gabeak2/STM32H743ZI_actuator_daughterboard/STM32H743ZI_actuator_daughterboard.kicad_pcb

## KiCad design STM32H743ZI_actuator_daughterboard.kicad_pcb (2026-04-05)

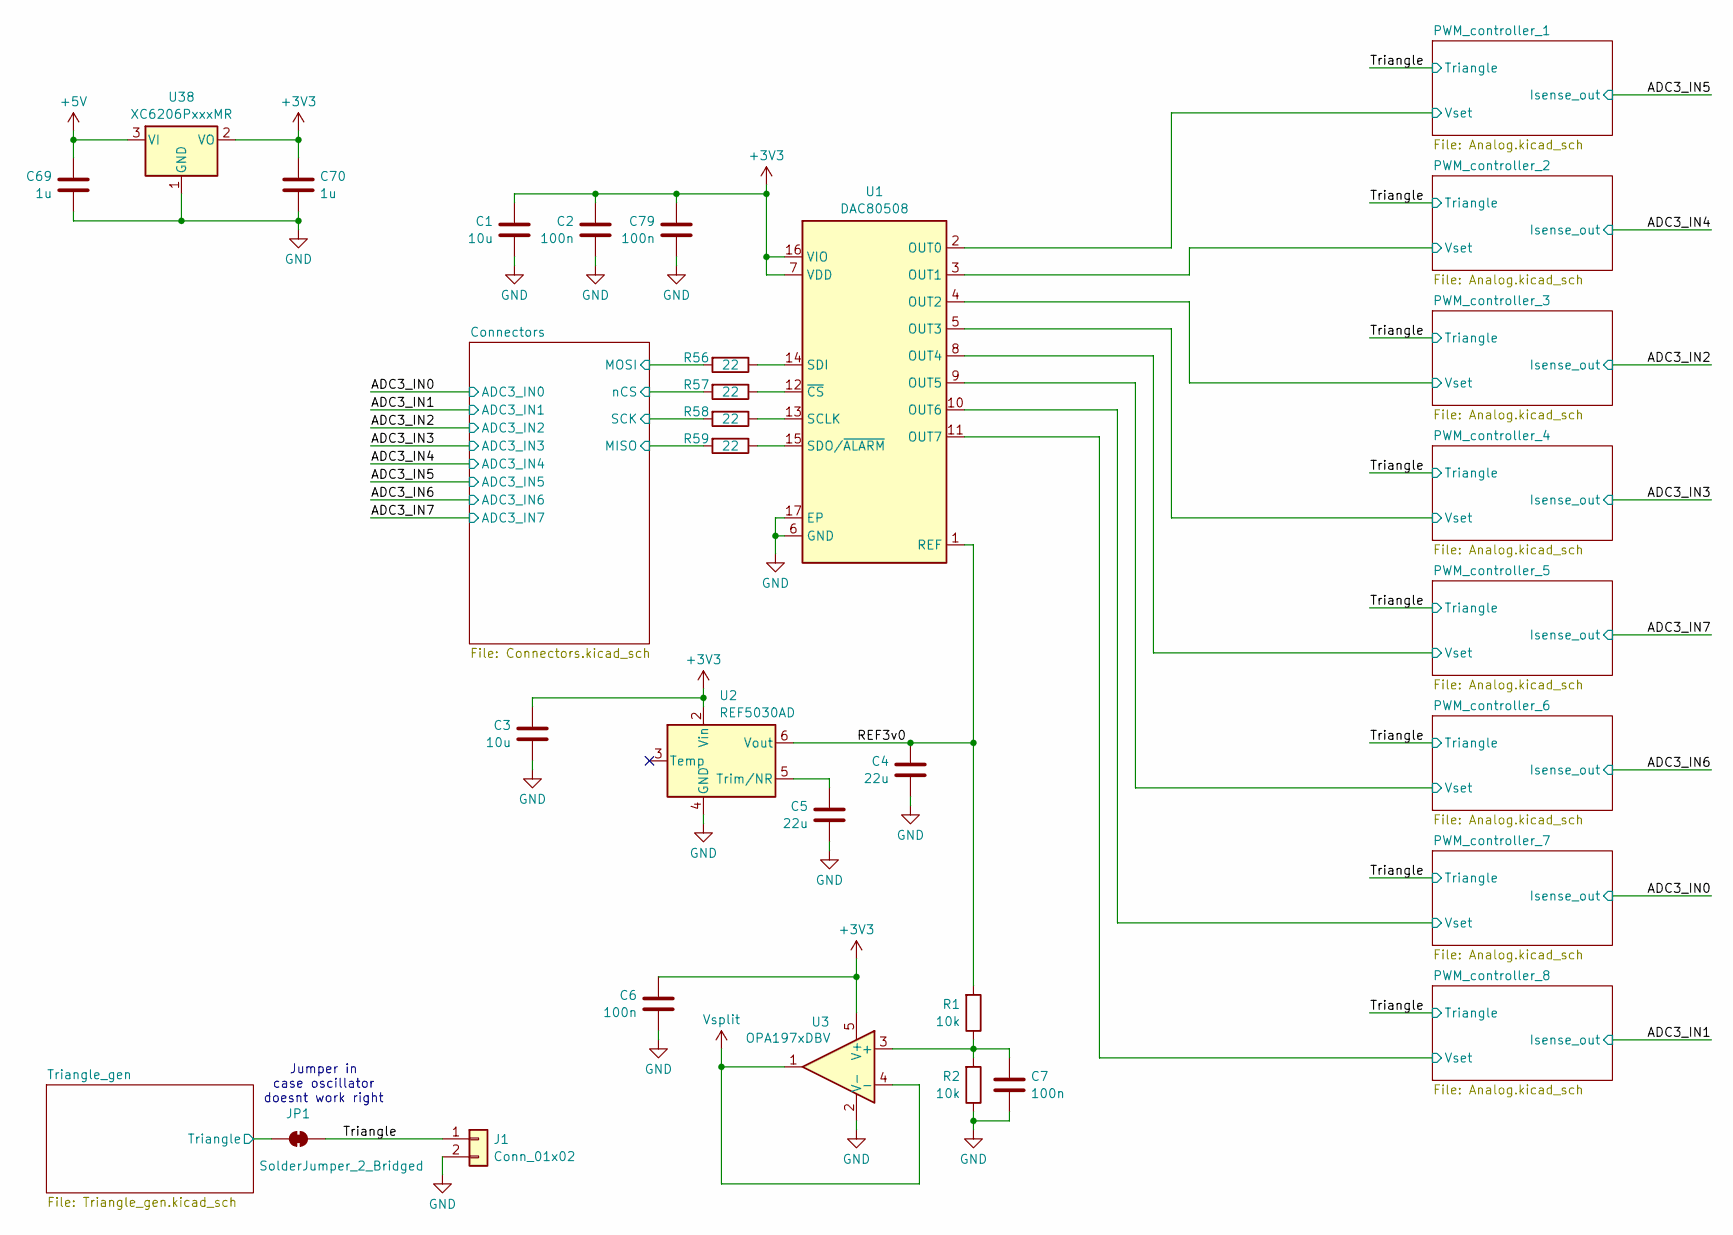
[picture p1: schematic STM32H743ZI_actuator_daughterboard.kicad_sch]

Parts:
C1, C3: 10u; C_0603_1608Metric; LCSC C19702
C2, C6, C7, C79: 100n; C_0603_1608Metric; LCSC C14663
C4, C5: 22u; C_0603_1608Metric; LCSC C59461
C69, C70: 1u; C_0603_1608Metric; LCSC C52923
J1: Conn_01x02; PinHeader_1x02_P2.54mm_Vertical
JP1: SolderJumper_2_Bridged; SolderJumper-2_P1.3mm_Bridged2Bar_Pad1.0x1.5mm
R1, R2: 10k; R_0603_1608Metric; LCSC C25804
R56, R57, R58, R59: 22; R_0603_1608Metric; LCSC C23345
U1: DAC80508; Texas_RTE0016D_WQFN-16-1EP_3x3mm_P0.5mm_EP0.8x0.8mm_Thermal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; LCSC C2679499
U2: REF5030AD; SOIC-8_3.9x4.9mm_P1.27mm; LCSC C69362
U3: OPA197xDBV; SOT-23-5; LCSC C221351
U38: XC6206PxxxMR; SOT-23-3; LCSC C5446

Connections:
+3V3: C1.1, C2.1, C3.1, C6.1, C70.1, C79.1, U1.7 (VDD), U1.16 (VIO), U2.2 (Vin), U3.5 (V+), U38.2 (VO); also elsewhere on the board
+5V: C69.1, U38.3 (VI); also elsewhere on the board
/Connectors/SPI1_MISO: R59.2; also elsewhere on the board
/Connectors/SPI1_MOSI: R56.2; also elsewhere on the board
/Connectors/SPI1_SCK: R58.2; also elsewhere on the board
/Connectors/SPI1_nCS: R57.2; also elsewhere on the board
/PWM_controller_1/Vset: U1.2 (OUT0); also elsewhere on the board
/PWM_controller_2/Vset: U1.3 (OUT1); also elsewhere on the board
/PWM_controller_3/Vset: U1.4 (OUT2); also elsewhere on the board
/PWM_controller_4/Vset: U1.5 (OUT3); also elsewhere on the board
/PWM_controller_5/Vset: U1.8 (OUT4); also elsewhere on the board
/PWM_controller_6/Vset: U1.9 (OUT5); also elsewhere on the board
/PWM_controller_7/Vset: U1.10 (OUT6); also elsewhere on the board
/PWM_controller_8/Vset: U1.11 (OUT7); also elsewhere on the board
/REF3v0: C4.1, R1.2, U1.1 (REF), U2.6 (Vout)
/Triangle: J1.1, JP1.1 (A); also elsewhere on the board
/Triangle_gen/Triangle: JP1.2 (B); also elsewhere on the board
GND: C1.2, C2.2, C3.2, C4.2, C5.2, C6.2, C7.2, C69.2, C70.2, C79.2, J1.2, R2.1, U1.6 (GND), U1.17 (EP), U2.4 (GND), U3.2 (V-), U38.1 (GND); also elsewhere on the board
unnamed: R58.1, U1.13 (SCLK)
unnamed: R56.1, U1.14 (SDI)
unnamed: R59.1, U1.15 (SDO/~ALARM)
unnamed: R57.1, U1.12 (~CS)
unnamed: C5.1, U2.5 (Trim/NR)
unnamed: C7.1, R1.1, R2.2, U3.3 (+)
Vsplit: U3.1, U3.4 (-); also elsewhere on the board

Notes on the sheet:
Jumper in case oscillator doesnt work right

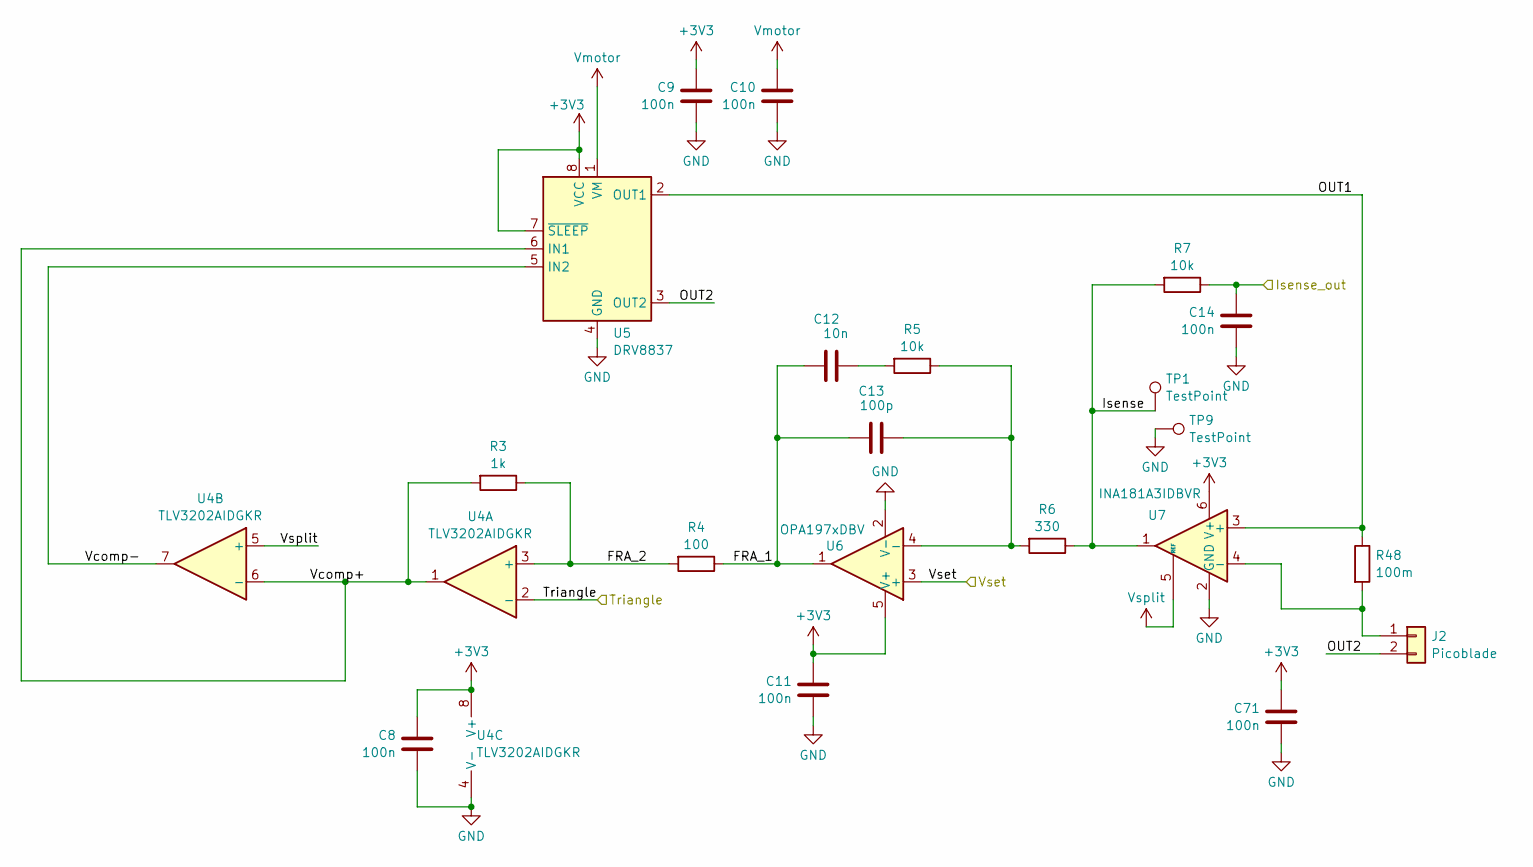
[picture p2: schematic Analog.kicad_sch]

Parts:
C8, C9, C10, C11, C14, C71: 100n; C_0603_1608Metric; LCSC C14663
C12: 10n; C_0603_1608Metric; LCSC C57112
C13: 100p; C_0603_1608Metric; LCSC C14858
J2: Picoblade; Molex_PicoBlade_53047-0210_1x02_P1.25mm_Vertical
R3: 1k; R_0603_1608Metric; LCSC C21190
R4: 100; R_0603_1608Metric; LCSC C22775
R5, R7: 10k; R_0603_1608Metric; LCSC C25804
R6: 330; R_0603_1608Metric; LCSC C23138
R48: 100m; R_1206_3216Metric; LCSC C25334
TP1, TP9: TestPoint; scope_tp
U4: TLV3202AIDGKR; VSSOP-8_3x3mm_P0.65mm; LCSC C478075
U5: DRV8837; WSON-8-1EP_2x2mm_P0.5mm_EP0.9x1.6mm; LCSC C39159
U6: OPA197xDBV; SOT-23-5; LCSC C221351
U7: INA181A3IDBVR; SOT-23-6; LCSC C2652255

Connections:
+3V3: C8.1, C9.1, C11.1, C71.1, U4.8 (V+), U5.7 (~SLEEP), U5.8 (VCC), U6.5 (V+), U7.6 (V+); also elsewhere on the board
/ADC3_IN5: C14.1, R7.1; also elsewhere on the board
/PWM_controller_1/FRA_1: C12.1, C13.1, R4.1, U6.1
/PWM_controller_1/FRA_2: R3.1, R4.2, U4.3 (+)
/PWM_controller_1/Isense: R6.1, R7.2, TP1.1 (1_1), U7.1
/PWM_controller_1/OUT1: R48.1, U5.2 (OUT1), U7.3 (+)
/PWM_controller_1/OUT2: J2.2, U5.3 (OUT2)
/PWM_controller_1/Vcomp+: R3.2, U4.1, U4.6 (-), U5.6 (IN1)
/PWM_controller_1/Vcomp-: U4.7, U5.5 (IN2)
/PWM_controller_1/Vset: U6.3 (+); also elsewhere on the board
/Triangle: U4.2 (-); also elsewhere on the board
GND: C8.2, C9.2, C10.2, C11.2, C14.2, C71.2, TP9.1 (1_1), U4.4 (V-), U5.4 (GND), U5.9 (GND), U6.2 (V-), U7.2 (GND); also elsewhere on the board
unnamed: C12.2, R5.2
unnamed: J2.1, R48.2, U7.4 (-)
unnamed: C13.2, R5.1, R6.2, U6.4 (-)
Vmotor: C10.1, U5.1 (VM); also elsewhere on the board
Vsplit: U4.5 (+), U7.5 (REF); also elsewhere on the board

Parts of its further copies:
C15, C16, C19, C20, C21, C22, C23, C26, C27, C28, C29, C30, C33, C34, C35, C36, C37, C40, C41, C42, C43, C44, C47, C48, C49, C50, C51, C54, C55, C56, C57, C58, C61, C62, C63, C72, C73, C74, C75, C76, C77, C78: 100n; C_0603_1608Metric; LCSC C14663
C17, C24, C31, C38, C45, C52, C59: 10n; C_0603_1608Metric; LCSC C57112
C18, C25, C32, C39, C46, C53, C60: 100p; C_0603_1608Metric; LCSC C14858
J5, J7, J9, J11, J13, J15, J17: Picoblade; Molex_PicoBlade_53047-0210_1x02_P1.25mm_Vertical
R8, R13, R18, R23, R28, R33, R38, R49, R50, R51, R52, R53, R54, R55: 10k; R_0603_1608Metric; LCSC C25804
R9, R14, R19, R24, R29, R34, R39: 1k; R_0603_1608Metric; LCSC C21190
R10, R15, R20, R25, R30, R35, R40: 330; R_0603_1608Metric; LCSC C23138
R11, R16, R21, R26, R31, R36, R41: 100; R_0603_1608Metric; LCSC C22775
R12, R17, R22, R27, R32, R37, R42: 100m; R_1206_3216Metric; LCSC C25334
TP2, TP3, TP4, TP5, TP6, TP7, TP8, TP10, TP11, TP12, TP13, TP14, TP15, TP16: TestPoint; scope_tp
U8, U12, U16, U20, U24, U28, U32: DRV8837; WSON-8-1EP_2x2mm_P0.5mm_EP0.9x1.6mm; LCSC C39159
U9, U13, U17, U21, U25, U29, U33: INA181A3IDBVR; SOT-23-6; LCSC C2652255
U10, U14, U18, U22, U26, U30, U34: TLV3202AIDGKR; VSSOP-8_3x3mm_P0.65mm; LCSC C478075
U11, U15, U19, U23, U27, U31, U35: OPA197xDBV; SOT-23-5; LCSC C221351

Connections of its further copies:
+3V3: C15.1, C19.1, C20.1, C21.1, C22.1, C26.1, C27.1, C28.1, C29.1, C33.1, C34.1, C35.1, C36.1, C40.1, C41.1, C42.1, C43.1, C47.1, C48.1, C49.1, C50.1, C54.1, C55.1, C56.1, C57.1, C61.1, C62.1, C63.1, U8.7 (~SLEEP), U8.8 (VCC), U9.6 (V+), U10.8 (V+), U11.5 (V+), U12.7 (~SLEEP), U12.8 (VCC), U13.6 (V+), U14.8 (V+), U15.5 (V+), U16.7 (~SLEEP), U16.8 (VCC), U17.6 (V+), U18.8 (V+), U19.5 (V+), U20.7 (~SLEEP), U20.8 (VCC), U21.6 (V+), U22.8 (V+), U23.5 (V+), U24.7 (~SLEEP), U24.8 (VCC), U25.6 (V+), U26.8 (V+), U27.5 (V+), U28.7 (~SLEEP), U28.8 (VCC), U29.6 (V+), U30.8 (V+), U31.5 (V+), U32.7 (~SLEEP), U32.8 (VCC), U33.6 (V+), U34.8 (V+), U35.5 (V+); also elsewhere on the board
/ADC3_IN0: C77.1, R54.1; also elsewhere on the board
/ADC3_IN1: C78.1, R55.1; also elsewhere on the board
/ADC3_IN2: C73.1, R50.1; also elsewhere on the board
/ADC3_IN3: C74.1, R51.1; also elsewhere on the board
/ADC3_IN4: C72.1, R49.1; also elsewhere on the board
/ADC3_IN6: C76.1, R53.1; also elsewhere on the board
/ADC3_IN7: C75.1, R52.1; also elsewhere on the board
/PWM_controller_2/FRA_1: C17.1, C18.1, R11.1, U11.1
/PWM_controller_2/FRA_2: R9.1, R11.2, U10.3 (+)
/PWM_controller_2/Isense: R10.1, R49.2, TP2.1 (1_1), U9.1
/PWM_controller_2/OUT1: R12.1, U8.2 (OUT1), U9.3 (+)
/PWM_controller_2/OUT2: J5.2, U8.3 (OUT2)
/PWM_controller_2/Vcomp+: R9.2, U8.6 (IN1), U10.1, U10.6 (-)
/PWM_controller_2/Vcomp-: U8.5 (IN2), U10.7
/PWM_controller_2/Vset: U11.3 (+); also elsewhere on the board
/PWM_controller_3/FRA_1: C24.1, C25.1, R16.1, U15.1
/PWM_controller_3/FRA_2: R14.1, R16.2, U14.3 (+)
/PWM_controller_3/Isense: R15.1, R50.2, TP3.1 (1_1), U13.1
/PWM_controller_3/OUT1: R17.1, U12.2 (OUT1), U13.3 (+)
/PWM_controller_3/OUT2: J7.2, U12.3 (OUT2)
/PWM_controller_3/Vcomp+: R14.2, U12.6 (IN1), U14.1, U14.6 (-)
/PWM_controller_3/Vcomp-: U12.5 (IN2), U14.7
/PWM_controller_3/Vset: U15.3 (+); also elsewhere on the board
/PWM_controller_4/FRA_1: C31.1, C32.1, R21.1, U19.1
/PWM_controller_4/FRA_2: R19.1, R21.2, U18.3 (+)
/PWM_controller_4/Isense: R20.1, R51.2, TP4.1 (1_1), U17.1
/PWM_controller_4/OUT1: R22.1, U16.2 (OUT1), U17.3 (+)
/PWM_controller_4/OUT2: J9.2, U16.3 (OUT2)
/PWM_controller_4/Vcomp+: R19.2, U16.6 (IN1), U18.1, U18.6 (-)
/PWM_controller_4/Vcomp-: U16.5 (IN2), U18.7
/PWM_controller_4/Vset: U19.3 (+); also elsewhere on the board
/PWM_controller_5/FRA_1: C38.1, C39.1, R26.1, U23.1
/PWM_controller_5/FRA_2: R24.1, R26.2, U22.3 (+)
/PWM_controller_5/Isense: R25.1, R52.2, TP5.1 (1_1), U21.1
/PWM_controller_5/OUT1: R27.1, U20.2 (OUT1), U21.3 (+)
/PWM_controller_5/OUT2: J11.2, U20.3 (OUT2)
/PWM_controller_5/Vcomp+: R24.2, U20.6 (IN1), U22.1, U22.6 (-)
/PWM_controller_5/Vcomp-: U20.5 (IN2), U22.7
/PWM_controller_5/Vset: U23.3 (+); also elsewhere on the board
/PWM_controller_6/FRA_1: C45.1, C46.1, R31.1, U27.1
/PWM_controller_6/FRA_2: R29.1, R31.2, U26.3 (+)
/PWM_controller_6/Isense: R30.1, R53.2, TP6.1 (1_1), U25.1
/PWM_controller_6/OUT1: R32.1, U24.2 (OUT1), U25.3 (+)
/PWM_controller_6/OUT2: J13.2, U24.3 (OUT2)
/PWM_controller_6/Vcomp+: R29.2, U24.6 (IN1), U26.1, U26.6 (-)
/PWM_controller_6/Vcomp-: U24.5 (IN2), U26.7
/PWM_controller_6/Vset: U27.3 (+); also elsewhere on the board
/PWM_controller_7/FRA_1: C52.1, C53.1, R36.1, U31.1
/PWM_controller_7/FRA_2: R34.1, R36.2, U30.3 (+)
/PWM_controller_7/Isense: R35.1, R54.2, TP7.1 (1_1), U29.1
/PWM_controller_7/OUT1: R37.1, U28.2 (OUT1), U29.3 (+)
/PWM_controller_7/OUT2: J15.2, U28.3 (OUT2)
/PWM_controller_7/Vcomp+: R34.2, U28.6 (IN1), U30.1, U30.6 (-)
/PWM_controller_7/Vcomp-: U28.5 (IN2), U30.7
/PWM_controller_7/Vset: U31.3 (+); also elsewhere on the board
/PWM_controller_8/FRA_1: C59.1, C60.1, R41.1, U35.1
/PWM_controller_8/FRA_2: R39.1, R41.2, U34.3 (+)
/PWM_controller_8/Isense: R40.1, R55.2, TP8.1 (1_1), U33.1
/PWM_controller_8/OUT1: R42.1, U32.2 (OUT1), U33.3 (+)
/PWM_controller_8/OUT2: J17.2, U32.3 (OUT2)
/PWM_controller_8/Vcomp+: R39.2, U32.6 (IN1), U34.1, U34.6 (-)
/PWM_controller_8/Vcomp-: U32.5 (IN2), U34.7
/PWM_controller_8/Vset: U35.3 (+); also elsewhere on the board
/Triangle: U10.2 (-), U14.2 (-), U18.2 (-), U22.2 (-), U26.2 (-), U30.2 (-), U34.2 (-); also elsewhere on the board
GND: C15.2, C16.2, C19.2, C20.2, C21.2, C22.2, C23.2, C26.2, C27.2, C28.2, C29.2, C30.2, C33.2, C34.2, C35.2, C36.2, C37.2, C40.2, C41.2, C42.2, C43.2, C44.2, C47.2, C48.2, C49.2, C50.2, C51.2, C54.2, C55.2, C56.2, C57.2, C58.2, C61.2, C62.2, C63.2, C72.2, C73.2, C74.2, C75.2, C76.2, C77.2, C78.2, TP10.1 (1_1), TP11.1 (1_1), TP12.1 (1_1), TP13.1 (1_1), TP14.1 (1_1), TP15.1 (1_1), TP16.1 (1_1), U8.4 (GND), U8.9 (GND), U9.2 (GND), U10.4 (V-), U11.2 (V-), U12.4 (GND), U12.9 (GND), U13.2 (GND), U14.4 (V-), U15.2 (V-), U16.4 (GND), U16.9 (GND), U17.2 (GND), U18.4 (V-), U19.2 (V-), U20.4 (GND), U20.9 (GND), U21.2 (GND), U22.4 (V-), U23.2 (V-), U24.4 (GND), U24.9 (GND), U25.2 (GND), U26.4 (V-), U27.2 (V-), U28.4 (GND), U28.9 (GND), U29.2 (GND), U30.4 (V-), U31.2 (V-), U32.4 (GND), U32.9 (GND), U33.2 (GND), U34.4 (V-), U35.2 (V-); also elsewhere on the board
unnamed: C17.2, R8.2
unnamed: C24.2, R13.2
unnamed: C31.2, R18.2
unnamed: C38.2, R23.2
unnamed: C45.2, R28.2
unnamed: C52.2, R33.2
unnamed: C59.2, R38.2
unnamed: J5.1, R12.2, U9.4 (-)
unnamed: J7.1, R17.2, U13.4 (-)
unnamed: J9.1, R22.2, U17.4 (-)
unnamed: J11.1, R27.2, U21.4 (-)
unnamed: J13.1, R32.2, U25.4 (-)
unnamed: J15.1, R37.2, U29.4 (-)
unnamed: J17.1, R42.2, U33.4 (-)
unnamed: C18.2, R8.1, R10.2, U11.4 (-)
unnamed: C25.2, R13.1, R15.2, U15.4 (-)
unnamed: C32.2, R18.1, R20.2, U19.4 (-)
unnamed: C39.2, R23.1, R25.2, U23.4 (-)
unnamed: C46.2, R28.1, R30.2, U27.4 (-)
unnamed: C53.2, R33.1, R35.2, U31.4 (-)
unnamed: C60.2, R38.1, R40.2, U35.4 (-)
Vmotor: C16.1, C23.1, C30.1, C37.1, C44.1, C51.1, C58.1, U8.1 (VM), U12.1 (VM), U16.1 (VM), U20.1 (VM), U24.1 (VM), U28.1 (VM), U32.1 (VM); also elsewhere on the board
Vsplit: U9.5 (REF), U10.5 (+), U13.5 (REF), U14.5 (+), U17.5 (REF), U18.5 (+), U21.5 (REF), U22.5 (+), U25.5 (REF), U26.5 (+), U29.5 (REF), U30.5 (+), U33.5 (REF), U34.5 (+); also elsewhere on the board

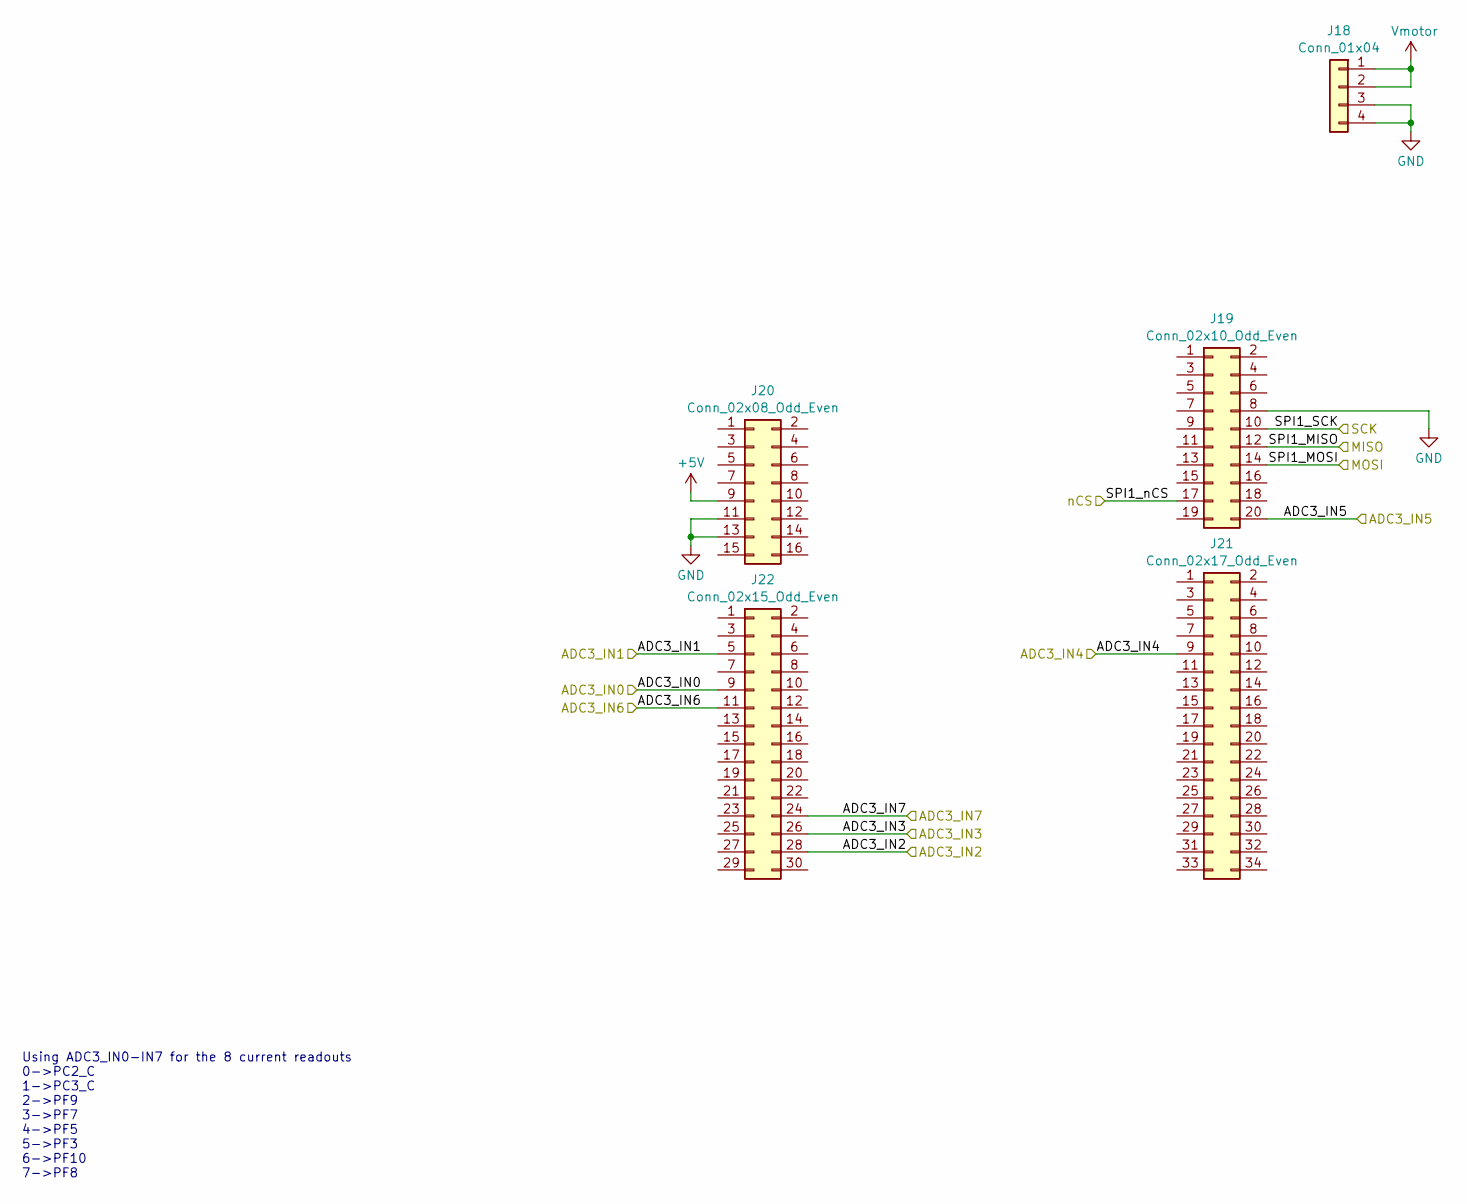
[picture p3: schematic Connectors.kicad_sch]

Parts:
J18: Conn_01x04; PinHeader_1x04_P2.54mm_Vertical
J19: Conn_02x10_Odd_Even; PinHeader_2x10_P2.54mm_Vertical
J20: Conn_02x08_Odd_Even; PinHeader_2x08_P2.54mm_Vertical
J21: Conn_02x17_Odd_Even; PinHeader_2x17_P2.54mm_Vertical
J22: Conn_02x15_Odd_Even; PinHeader_2x15_P2.54mm_Vertical

Connections:
+5V: J20.9; also elsewhere on the board
/ADC3_IN0: J22.9; also elsewhere on the board
/ADC3_IN1: J22.5; also elsewhere on the board
/ADC3_IN2: J22.28; also elsewhere on the board
/ADC3_IN3: J22.26; also elsewhere on the board
/ADC3_IN4: J21.9 (Pin_9_9); also elsewhere on the board
/ADC3_IN5: J19.20; also elsewhere on the board
/ADC3_IN6: J22.11; also elsewhere on the board
/ADC3_IN7: J22.24; also elsewhere on the board
/Connectors/SPI1_MISO: J19.12; also elsewhere on the board
/Connectors/SPI1_MOSI: J19.14; also elsewhere on the board
/Connectors/SPI1_SCK: J19.10; also elsewhere on the board
/Connectors/SPI1_nCS: J19.17; also elsewhere on the board
GND: J18.3, J18.4, J19.8, J20.11, J20.13; also elsewhere on the board
Vmotor: J18.1, J18.2; also elsewhere on the board

Notes on the sheet:
Using ADC3_IN0-IN7 for the 8 current readouts 0->PC2_C 1->PC3_C 2->PF9 3->PF7 4->PF5 5->PF3 6->PF10 7->PF8

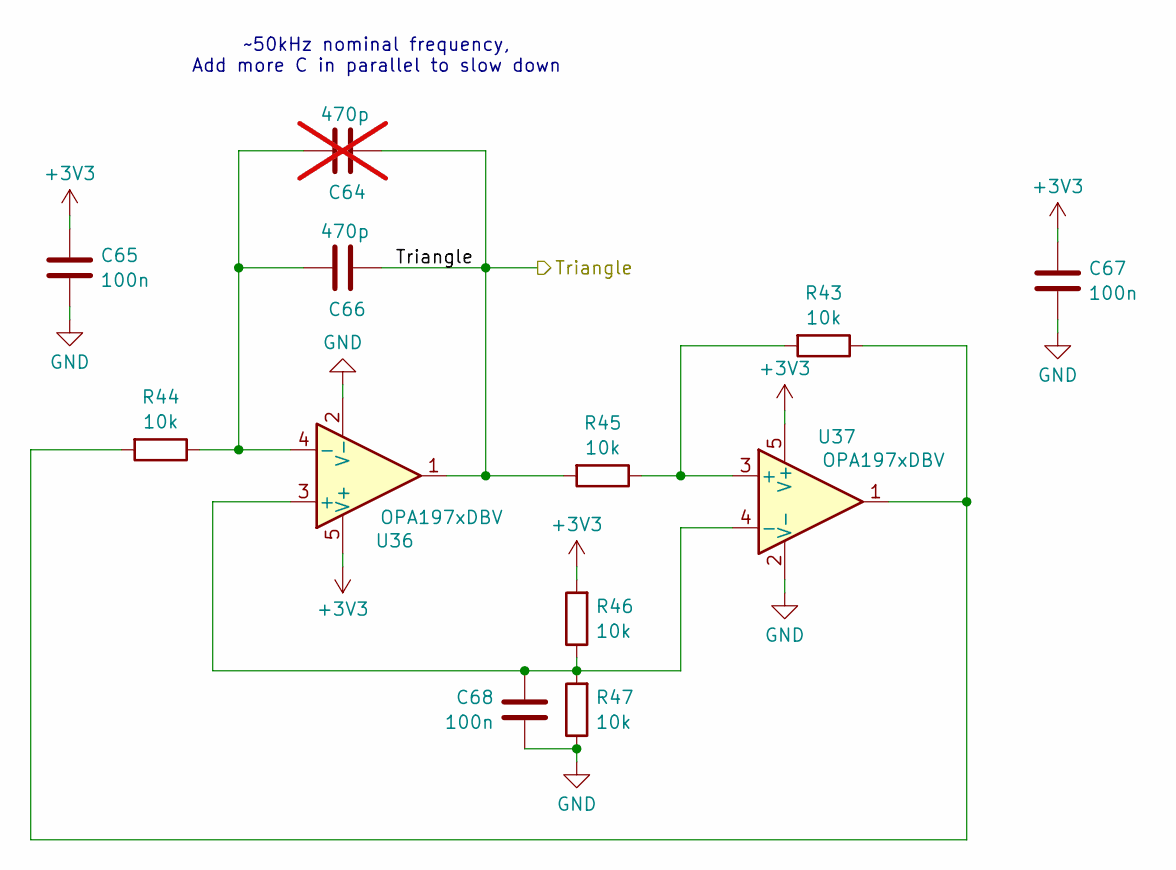
[picture p4: schematic Triangle_gen.kicad_sch]

Parts:
C64: 470p; C_0603_1608Metric; LCSC C1620; not fitted
C65, C67, C68: 100n; C_0603_1608Metric; LCSC C14663
C66: 470p; C_0603_1608Metric; LCSC C1620
R43, R44, R45, R46, R47: 10k; R_0603_1608Metric; LCSC C25804
U36, U37: OPA197xDBV; SOT-23-5; LCSC C221351

Connections:
+3V3: C65.1, C67.1, R46.2, U36.5 (V+), U37.5 (V+); also elsewhere on the board
/Triangle_gen/Triangle: C64.1, C66.1, R45.2, U36.1; also elsewhere on the board
GND: C65.2, C67.2, C68.2, R47.1, U36.2 (V-), U37.2 (V-); also elsewhere on the board
unnamed: R43.1, R44.2, U37.1
unnamed: C68.1, R46.1, R47.2, U36.3 (+), U37.4 (-)
unnamed: C64.2, C66.2, R44.1, U36.4 (-)
unnamed: R43.2, R45.1, U37.3 (+)

Notes on the sheet:
~50kHz nominal frequency, Add more C in parallel to slow down

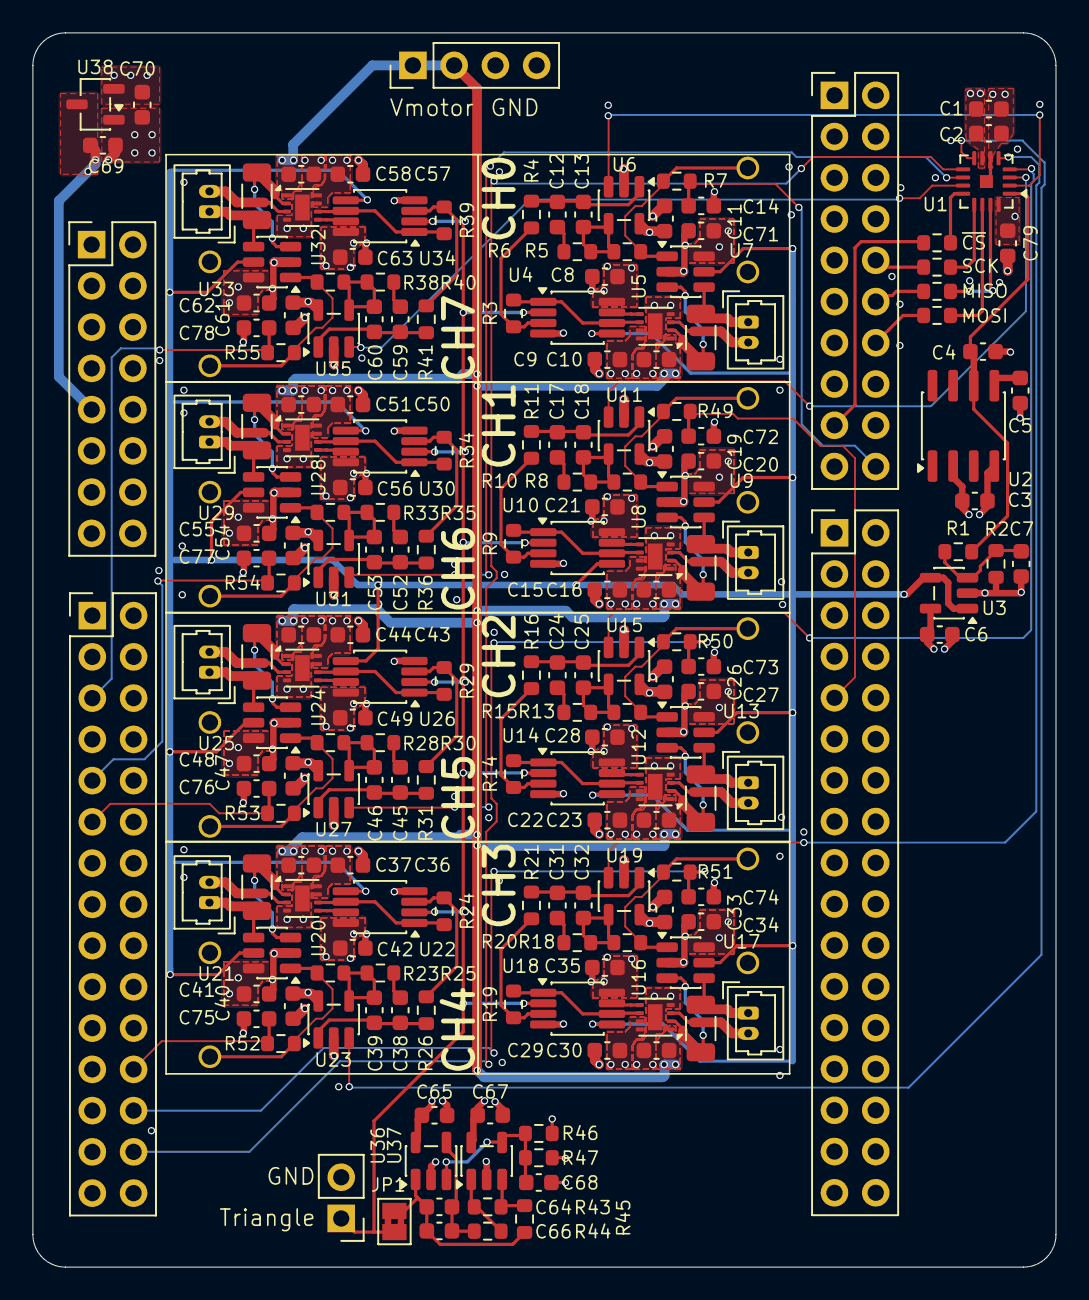
[picture p5: board STM32H743ZI_actuator_daughterboard.kicad_pcb from above]

Board: 4 copper layers, 63.0 x 76.0 mm, 207 parts (0 on the bottom side), 118 nets.
