gabeak2/STM32H743ZI_actuator_daughterboard/(commit log)

2026-03-28 8ch layout applied, connectors aligned to nucleo
    [Analog.kicad_sch, Connectors.kicad_sch, Power.kicad_sch, STM32H743ZI_actuator_daughterboard.kicad_pcb, STM32H743ZI_actuator_daughterboard.kicad_sch, Triangle_gen.kicad_sch]
2026-03-28 Working on how to arrange 8 channels
    [Power.kicad_sch, STM32H743ZI_actuator_daughterboard.kicad_pcb, STM32H743ZI_actuator_daughterboard.kicad_sch]
2026-04-04 Continuing layout, added ADC connections for current measurements
    [Connectors.kicad_sch, STM32H743ZI_actuator_daughterboard.kicad_pcb, STM32H743ZI_actuator_daughterboard.kicad_sch]
2026-04-05 Basically Done with Layout, final checks and let it sit a day before ordering
    [STM32H743ZI_actuator_daughterboard.kicad_pcb, STM32H743ZI_actuator_daughterboard.kicad_sch]
